sgust/Amiga-A1012-PCB/README.md

This is a small PCB board for my Amiga A1012 double floppy project.
