sgust/Amiga-A1012-PCB/2017-06-05/Amiga-A1012.pdf

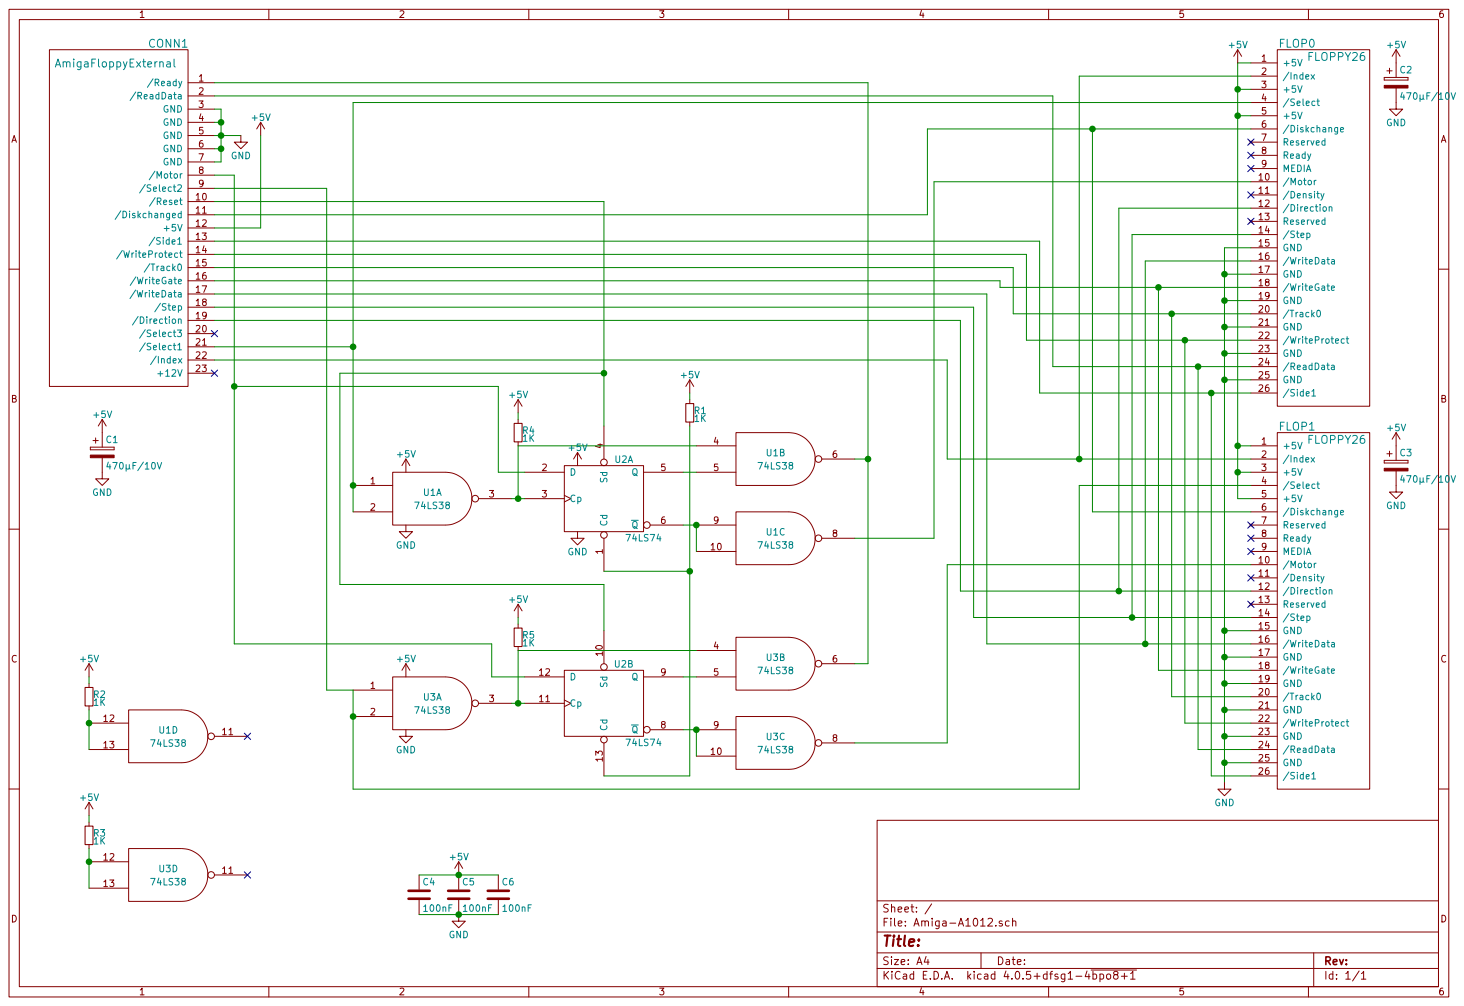
[picture p1: page 1]

/Diskchange 6 Reserved 7 Ready 8 MEDIA 9 /Motor 10
/Density 11 GND 21 /Step 14
/Direction 12
/ReadData 24 GND 15 GND 25
/WriteData 16

FLOPPY26 GND /Diskchange 6 Reserved 7 Ready 8 MEDIA 9 /Motor 10

/Index 2 +5V 3

File: Amiga-A1012.sch Sheet: /
