sgust/Amiga-A1012-PCB/Amiga-A1012.kicad_pcb

## KiCad design Amiga-A1012.kicad_pcb (2017-06-29)

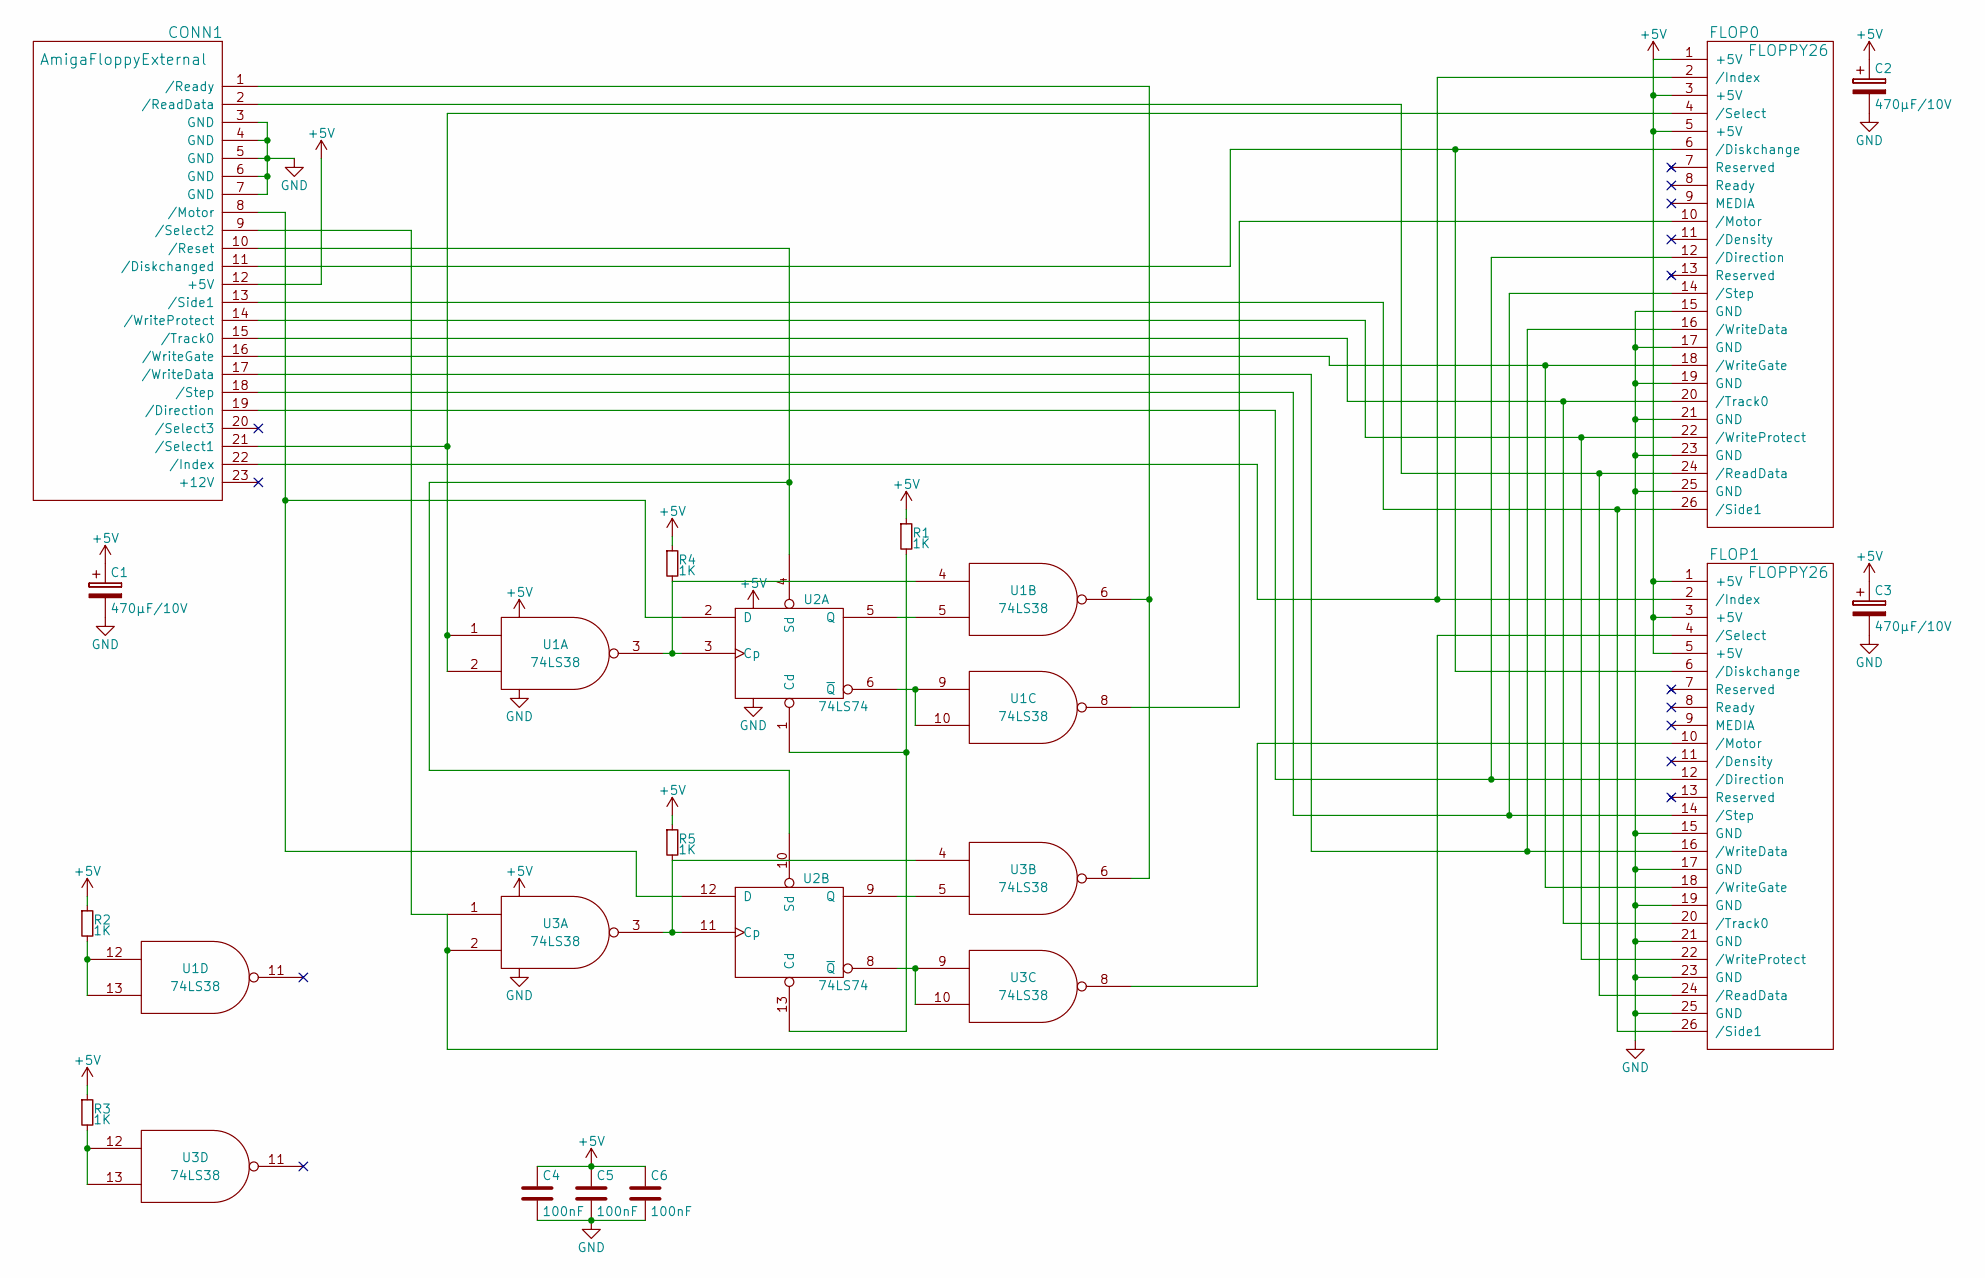
[picture p2: schematic Amiga-A1012.sch]

Parts:
C1, C2, C3: 470µF/10V; Tantalum_Case-D_EIA-7343-31_Reflow
C4, C5, C6: 100nF; R_0603
CONN1: AmigaFloppyExternal; Pin_Header_Angled_2x12
FLOP0, FLOP1: FLOPPY26; FFC-26
R1, R2, R3, R4, R5: 1K; R_0603
U1, U3: 74LS38; SOIC-14_N
U2: 74LS74; SOIC-14_N

Connections:
+5V: C1.1, C2.1, C3.1, C4.1, C5.1, C6.1, CONN1.12 (+5V), FLOP0.1 (+5V), FLOP0.3 (+5V), FLOP0.5 (+5V), FLOP1.1 (+5V), FLOP1.3 (+5V), FLOP1.5 (+5V), R1.1, R2.1, R3.1, R4.1, R5.1, U1.14 (VCC), U2.14 (VCC), U3.14 (VCC)
GND: C1.2, C2.2, C3.2, C4.2, C5.2, C6.2, CONN1.3 (GND), CONN1.4 (GND), CONN1.5 (GND), CONN1.6 (GND), CONN1.7 (GND), FLOP0.15 (GND), FLOP0.17 (GND), FLOP0.19 (GND), FLOP0.21 (GND), FLOP0.23 (GND), FLOP0.25 (GND), FLOP1.15 (GND), FLOP1.17 (GND), FLOP1.19 (GND), FLOP1.21 (GND), FLOP1.23 (GND), FLOP1.25 (GND), U1.7 (GND), U2.7 (GND), U3.7 (GND)
unnamed: CONN1.1 (/Ready), U1.6, U3.6
unnamed: CONN1.2 (/ReadData), FLOP0.24 (/ReadData), FLOP1.24 (/ReadData)
unnamed: CONN1.8 (/Motor), U2.2 (D), U2.12 (D)
unnamed: CONN1.9 (/Select2), FLOP1.4 (/Select), U3.1, U3.2
unnamed: CONN1.10 (/Reset), U2.4 (Sd), U2.10 (Sd)
unnamed: CONN1.11 (/Diskchanged), FLOP0.6 (/Diskchange), FLOP1.6 (/Diskchange)
unnamed: CONN1.13 (/Side1), FLOP0.26 (/Side1), FLOP1.26 (/Side1)
unnamed: CONN1.14 (/WriteProtect), FLOP0.22 (/WriteProtect), FLOP1.22 (/WriteProtect)
unnamed: CONN1.15 (/Track0), FLOP0.20 (/Track0), FLOP1.20 (/Track0)
unnamed: CONN1.16 (/WriteGate), FLOP0.18 (/WriteGate), FLOP1.18 (/WriteGate)
unnamed: CONN1.17 (/WriteData), FLOP0.16 (/WriteData), FLOP1.16 (/WriteData)
unnamed: CONN1.18 (/Step), FLOP0.14 (/Step), FLOP1.14 (/Step)
unnamed: CONN1.19 (/Direction), FLOP0.12 (/Direction), FLOP1.12 (/Direction)
unnamed: CONN1.21 (/Select1), FLOP0.4 (/Select), U1.1, U1.2
unnamed: CONN1.22 (/Index), FLOP0.2 (/Index), FLOP1.2 (/Index)
unnamed: FLOP0.10 (/Motor), U1.8
unnamed: FLOP1.10 (/Motor), U3.8
unnamed: R1.2, U2.1 (Cd), U2.13 (Cd)
unnamed: R2.2, U1.12, U1.13
unnamed: R3.2, U3.12, U3.13
unnamed: R4.2, U1.3, U1.4, U2.3 (Cp)
unnamed: R5.2, U2.11 (Cp), U3.3, U3.4
unnamed: U1.5, U2.5 (Q)
unnamed: U1.9, U1.10, U2.6 (~Q)
unnamed: U2.8 (~Q), U3.9, U3.10
unnamed: U2.9 (Q), U3.5

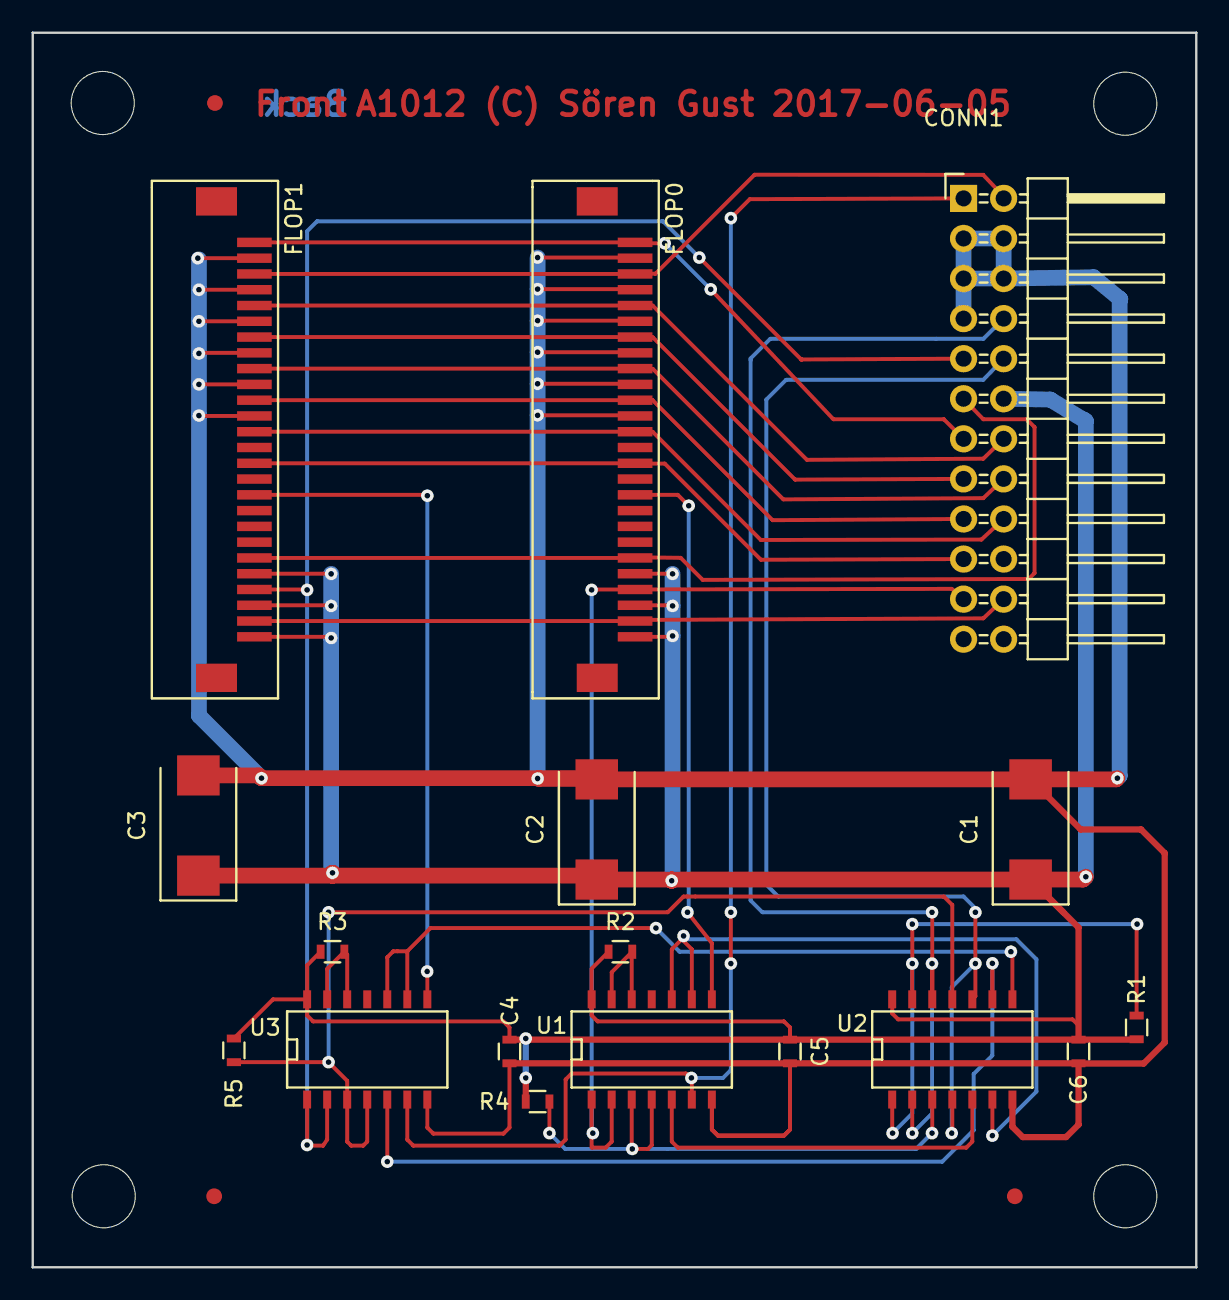
[picture p3: board Amiga-A1012.kicad_pcb from above]

Board: 2 copper layers, 73.8 x 78.2 mm, 24 parts (0 on the bottom side), 28 nets.

Other parts of the board:
Hole1, Hole2, Hole3, Hole4: MountingHole_4mm
Marker1, Marker2, Marker3: Fiducial_1mm_Dia_2.54mm_Outer_CopperTop
