sgust/Amiga-A1012-PCB/(commit log)

2017-04-23 Initial commit: Schematic entry complete. Seperated components on board.
    [Amiga-A1012.kicad_pcb, Amiga-A1012.sch]
2017-04-23 Started placing and routing, only big caps and connectors.
    [Amiga-A1012.kicad_pcb]
2017-04-26 Added decoupling caps. More routing.
    [Amiga-A1012.kicad_pcb, Amiga-A1012.sch]
2017-04-27 More routing. Connected VCC to +5V net, for LS chips.
    [Amiga-A1012.kicad_pcb, Amiga-A1012.sch]
2017-04-29 Finished routing. Fixed routing problems with unconnected nets. Added fiducials.
    [Amiga-A1012.kicad_pcb, Amiga-A1012.sch]
2017-04-30 Added mounting holes, moved fiducials.
    [Amiga-A1012.kicad_pcb]
2017-04-30 Generated gerber.
    [Amiga-A1012.kicad_pcb]
2017-04-30 Store gerber files.
    [Amiga-A1012-B.Cu.gbr, Amiga-A1012-B.Mask.gbr, Amiga-A1012-Edge.Cuts.gbr, Amiga-A1012-F.Cu.gbr, Amiga-A1012-F.Fab.gbr, Amiga-A1012-F.Mask.gbr, Amiga-A1012-F.SilkS.gbr, Amiga-A1012-NPTH.drl]
2017-04-30 Added Front/Back texts, added copyright/date.
    [Amiga-A1012-B.Cu.gbr, Amiga-A1012-B.Mask.gbr, Amiga-A1012-Edge.Cuts.gbr, Amiga-A1012-F.Cu.gbr, Amiga-A1012-F.Fab.gbr, Amiga-A1012-F.Mask.gbr, Amiga-A1012-F.SilkS.gbr, Amiga-A1012-NPTH.drl]
2017-05-31 Work in progress, fixing problems found in prototype: * swapped clock and data on LS74 * need pull-up on LS38 to LS74 * add pull-ups on unused LS38 gates * connect drive reset
    Started to reduce size.
    [Amiga-A1012.kicad_pcb, Amiga-A1012.sch]
2017-06-05 Finished routing, board is much smaller now.
    [Amiga-A1012.kicad_pcb]
2017-06-05 Made all vias bigger to allow cheaper eurocircuits manufacturing.
    [Amiga-A1012.kicad_pcb]
2017-06-29 Removed gerber for old release.
    [Amiga-A1012-B.Cu.gbr, Amiga-A1012-B.Mask.gbr, Amiga-A1012-Edge.Cuts.gbr, Amiga-A1012-F.Cu.gbr, Amiga-A1012-F.Fab.gbr, Amiga-A1012-F.Mask.gbr, Amiga-A1012-F.SilkS.gbr, Amiga-A1012-NPTH.drl]
2017-06-29 Added Würth number for floppy connector.
2017-06-29 Named holes and fiducials.
    [Amiga-A1012.kicad_pcb]
2017-06-29 Created gerber files.
    [Amiga-A1012-B.Cu.gbr, Amiga-A1012-B.Mask.gbr, Amiga-A1012-Edge.Cuts.gbr, Amiga-A1012-F.Cu.gbr, Amiga-A1012-F.Fab.gbr, Amiga-A1012-F.Mask.gbr, Amiga-A1012-F.SilkS.gbr, Amiga-A1012-NPTH.drl]
2017-06-29 Created 2 different BOM files.
    [Amiga-A1012.csv]
2017-06-29 Added Schematic as PDF.
